Tsjakka/ChickenCoop/Photos/20211030_194140.jpg

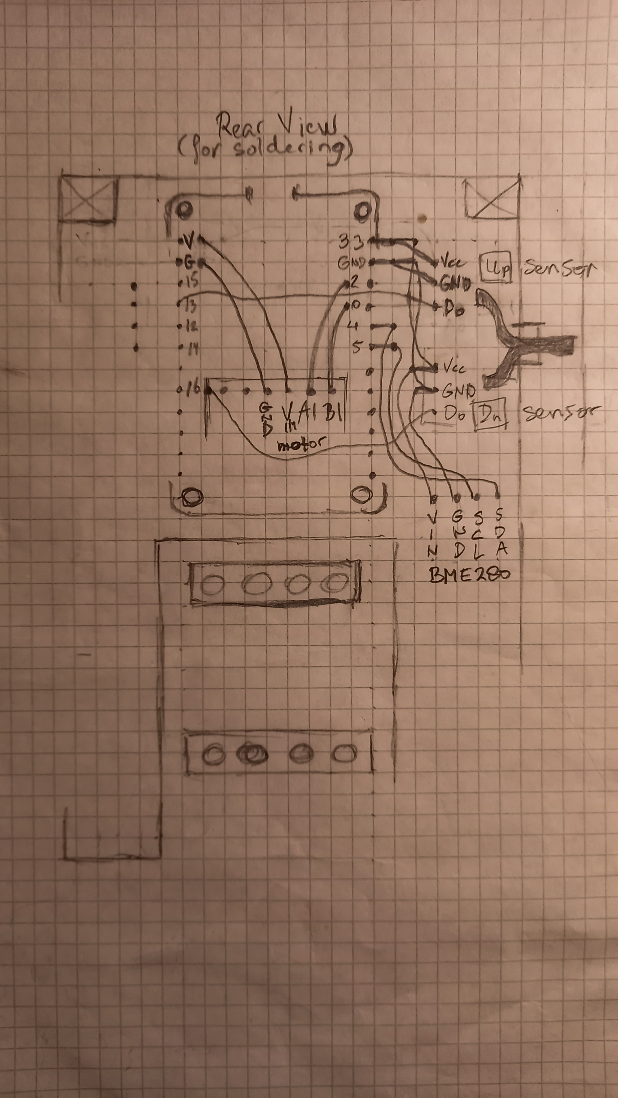
Photos/20211030_194140.jpg
