Tsjakka/ChickenCoop/Photos/20211031_101204.jpg

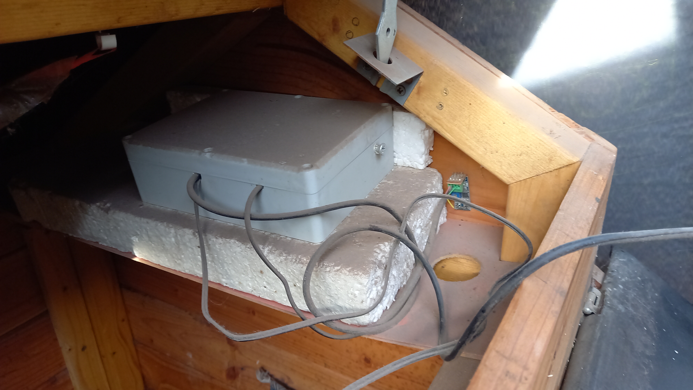
Photos/20211031_101204.jpg
