Tsjakka/ChickenCoop/Photos/20211031_101217.jpg

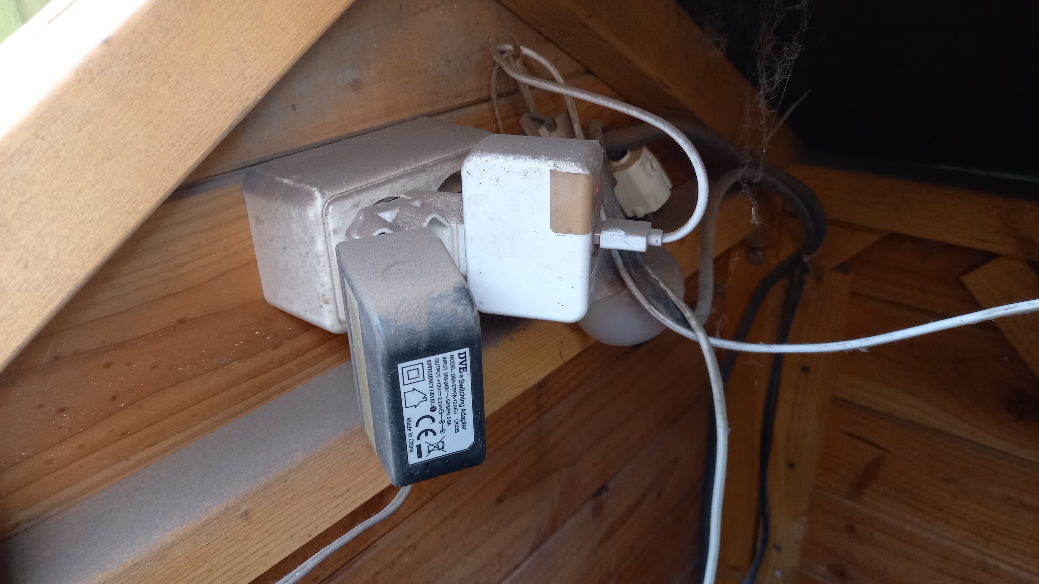
Photos/20211031_101217.jpg
