Tsjakka/ChickenCoop/Photos/IMG_20200118_174841104.jpg

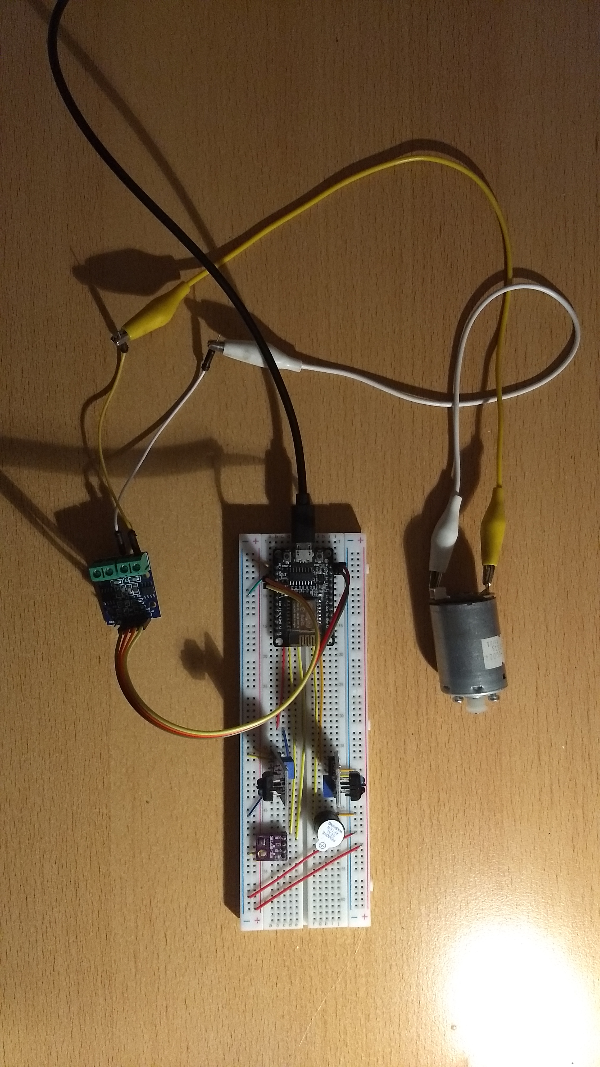
Photos/IMG_20200118_174841104.jpg
