Tsjakka/ChickenCoop/Photos/IMG_20200118_174915592.jpg

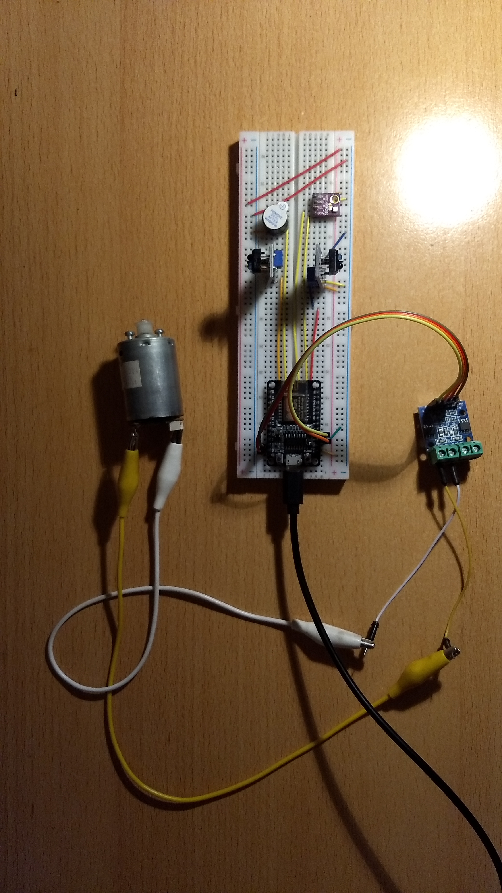
Photos/IMG_20200118_174915592.jpg
