Tsjakka/ChickenCoop/Photos/IMG_20200526_195358386.jpg

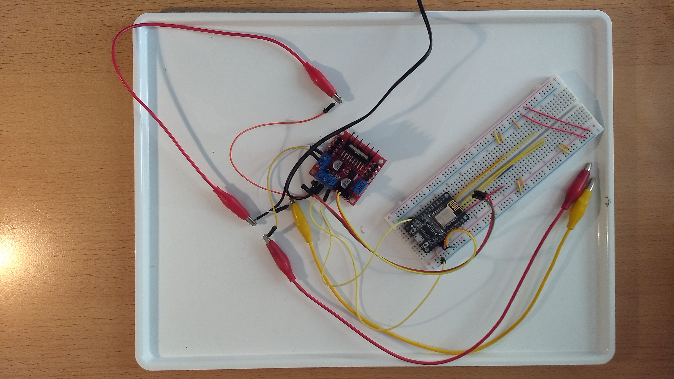
Photos/IMG_20200526_195358386.jpg
