Tsjakka/ChickenCoop/Photos/IMG_20200526_195407602.jpg

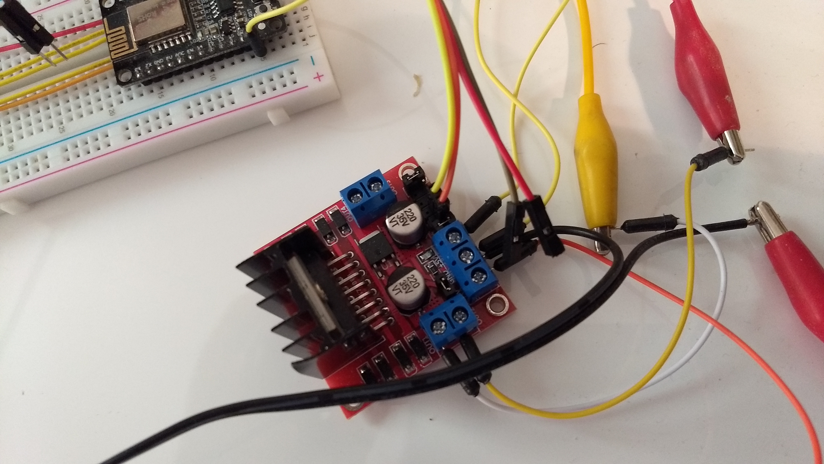
Photos/IMG_20200526_195407602.jpg
