Tsjakka/ChickenCoop/Photos/IMG_20200527_195943186.jpg

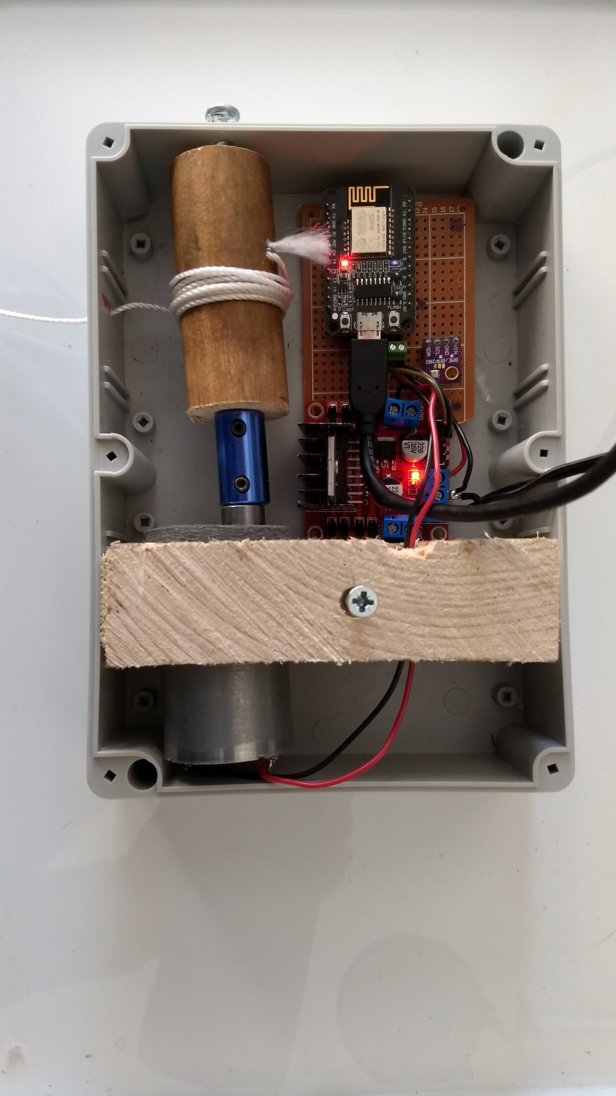
Photos/IMG_20200527_195943186.jpg
