Tsjakka/ChickenCoop/Photos/Webpage.gif

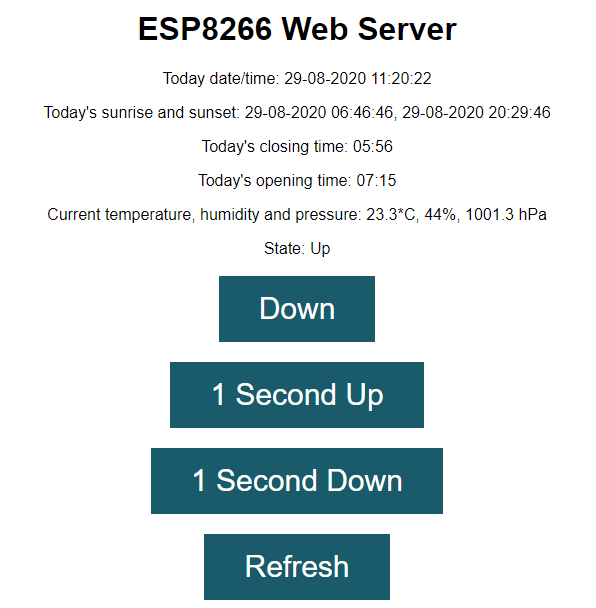
Photos/Webpage.gif
