Tsjakka/ChickenCoop/(commit log)

2020-06-07 Added .ino file (for Arduino IDE) and some photos.
2021-10-31 Upper sensor now used in calibration procedure instead of when opening the door. Added electric schematics.
2022-11-16 Replaced email client library because of stability issues. Added debug texts to web page. Added DST calculation. Several small improvements.
    [ChickenDoor.ino]
